Greg-R/magloop_pico_pcb_2/README.md

#  Printed Circuit Board for Magnetic Loop Antenna Controller Version 2

Design and fabrication files the Magnetic Loop Antenna Controller printed circuit board.

#  License

Please refer to the LICENSE file included in this repository.
