Greg-R/magloop_pico_pcb_2/bom/AmazonEbayPartsLoopController.ods

Sheet: Amazon
Amazon
Part | URL | Quantity for Project
Stepper Driver Module | https://www.amazon.com/gp/product/B01FFGAKK8
ILI9341 Display Module | https://www.amazon.com/gp/product/B073R7BH1B | 1
AD9850 DDS Module | https://www.amazon.com/gp/product/B01J7XPWNU | 1
Coaxial connector for relay | https://www.amazon.com/gp/product/B08Y7YWF3S | 1
Panel mount fuse holder and fuses | https://www.amazon.com/gp/product/B07VT4VRW7 | 1
Rotary encoders (not modules) with knobs | https://www.amazon.com/gp/product/B07DM2YMT4 | 3
Pushbuttons | https://www.amazon.com/gp/product/B0752RMB7Q | 3
Toggle switch for on/off | https://www.amazon.com/gp/product/B0799NSBHY | 1
Heatsink cooler fin for LM7805 | https://www.amazon.com/gp/product/B07MHT5KNP | 1
8 pin IDC connector with ribbon cable for display | https://www.amazon.com/gp/product/B07FKLHWT7 | 1
6 pin IDC connector with ribbon cable for push buttons and encoders | https://www.amazon.com/gp/product/B075PLZK9X | 2
JST connectors | https://www.amazon.com/gp/product/B01MCZE2HM | 3
JST crimping tool | https://www.amazon.com/gp/product/B01N4L8QMW | 1
Chanzon 1N5711, recommended diode | https://www.amazon.com/gp/product/B079KJBVZV | 4
Ethernet to screw terminal board, used at antenna | https://www.amazon.com/gp/product/B06XZ3BMTL | 1
Cat7 Ethernet Cable Outdoor rated | https://www.amazon.com/Outdoor-Ethernet-SNANSHI-1000Mbit-Waterproof/dp/B06ZZ1SKD6?th=1 | 1
Nylon hardware kit for assembling enclosure | https://www.amazon.com/HVAZI-Metric-Phillips-Screws-Assortment/dp/B07DVD95YY?th=1
Adhesive feet for controller enclosure | https://www.amazon.com/Bumper-Stopper-Protector-Adhesive-Headboard/dp/B0811DSRQB | 4
25 foot BNC cable | https://www.amazon.com/gp/product/B00K4D19IU?th=1 | 1
Plexiglas 10x10 | https://www.amazon.com/gp/product/B089P1KZ44?th=1 | 1
Large pulley 5mm bore | https://www.amazon.com/gp/product/B09NNBQP9T | 1
Small pulley 5mm bore | https://www.amazon.com/gp/product/B07DMWJJ6X?th=1 | 1
Belt, 6mm width, 260mm length | https://www.amazon.com/gp/product/B07B5Y4MGZ | 1
Limit switches | https://www.amazon.com/gp/product/B08CDF3Q6T | 2
Nylon bolts for antenna M8 30mm supports | https://www.amazon.com/gp/product/B012TAVQJW
Nylon bolts for tuner support brackets M8 40mm | https://www.amazon.com/gp/product/B0936RBF53
Nylon bolts for enclosure | https://www.amazon.com/gp/product/B07DVD95YY
Nylon bolts 6mm used on tuner assembly | https://www.amazon.com/gp/product/B07QWM86GX
Stepper Motor, 0.9 degree steps | https://www.amazon.com/gp/product/B0B8HB5N4S | 1

Sheet: eBay
eBay
Part | URL | Quantity for Project
Substitute for cancelled Digikey BNC | https://www.ebay.com/itm/232652734283
