Greg-R/magloop_pico_pcb_2/bom/MagLoop_Digikey.xlsx

Country of Origin may be different at time of shipment.
The HTSUS and ECCN information shown is for informational purposes only and is not a representation or warranty as to the accuracy or reliability of these classifications. All information is provided "as is" and is subject to change without notice. Any use made of the information provided is without recourse to Digi-Key and at the user's risk.
Index | Manufacturer Part Number | Manufacturer Name | Description | Availability | Stock Status | Attrition % | Requested Quantity 1 | Pack Quantity 1 | Pack Type 1 | Digi-Key Part Number 1 | Unit Price 1 | Extended Price 1 | Minimum Order Quantity 1 | Customer Reference | Requested Part Number | Lead Weeks | Datasheet | Reference Designator | US Import Tariff | Note | Part Status | RoHS Status | ECCN | HTSUS | Country of Origin | Environmental Information | Original Part numbers | Image
1 | PJ-036AH-SMT-TR | CUI Devices | CONN PWR JACK 2X5.5MM SOLDER | 63,562 | In Stock |  | 1 | 1 | Cut Tape (CT) | CP-036AHPJCT-ND | 1.43000 | $1.43 | 1 |  | CP-036AHPJCT-ND | 14 | https://www.cuidevices.com/product/resource/digikeypdf/pj-036ah-smt-tr.pdf |  | N/A |  | Active | ROHS3 Compliant | EAR99 | 8536.69.4040 | China | https://www.cuidevices.com/product/resource/material-compliance/pj-036ah-smt-tr | CP-036AHPJCT-ND | //media.digikey.com/photos/CUI%20Photos/MFG_PJ-036AH-SMT.jpg
2 | UVR1V100MDD | Nichicon | CAP ALUM 10UF 20% 35V RADIAL | 0 | Normally Stocking |  | 1 | 1 | Bulk | 493-1077-ND | 0.25000 | $0.25 | 1 |  | 493-1077-ND | 64 | https://download.datasheets.com/pdfs/2016/10/6/6/6/44/578/nch_/manual/93896153625063e-uvr.pdf |  | N/A |  | Active | ROHS3 Compliant | EAR99 | 8532.22.0020 | Malaysia |  | 493-1077-ND | //media.digikey.com/photos/Nichicon%20Photos/VR%20SERIES%20YELLOW%20HIGHLIGHT%20990-992.jpg
3 | ERJ-P08J752V | Panasonic Electronic Components | RES SMD 7.5K OHM 5% 2/3W 1206 | 2,311 | In Stock |  | 1 | 1 | Cut Tape (CT) | P7.5KALCT-ND | 0.17000 | $0.17 | 1 |  | P7.5KALCT-ND | 54 | https://industrial.panasonic.com/cdbs/www-data/pdf/RDO0000/AOA0000C331.pdf |  | N/A |  | Active | ROHS3 Compliant | EAR99 | 8533.21.0030 | Japan | https://industrial.panasonic.com/cdbs/www-cgi/auto-publishing.cgi?type=ROSU&region=WW&layer=4&cd=AOA0002 | P7.5KALCT-ND | //media.digikey.com/Renders/Panasonic%20Renders/ERJ-1206%20Pkg.jpg
4 | PPPC081LFBN-RC | Sullins Connector Solutions | CONN HDR 8POS 0.1 GOLD PCB | 92,192 | In Stock |  | 1 | 1 | Tray | S7041-ND | 0.67000 | $0.67 | 1 |  | S7041-ND | 11 | //media.digikey.com/pdf/Data%20Sheets/Sullins%20PDFs/Female_Headers.100_DS.pdf |  | N/A |  | Active | ROHS3 Compliant | EAR99 | 8536.69.4040 | Taiwan | https://www.sullinscorp.com/wp-content/uploads/2019/03/Sullins-RoHS-Compliant-Statement.pdf|https://www.sullinscorp.com/wp-content/uploads/2021/05/Sullins-REACH-211-SVHC-Compliant-Statement.pdf | S7041-ND | //media.digikey.com/photos/Sullins%20Photos/PPPC081LFBN-RC.jpg
5 | PPPC101LFBN-RC | Sullins Connector Solutions | CONN HDR 10POS 0.1 GOLD PCB | 130,868 | In Stock |  | 1 | 1 | Tray | S7043-ND | 0.68000 | $0.68 | 1 |  | S7043-ND | 11 | //media.digikey.com/pdf/Data%20Sheets/Sullins%20PDFs/Female_Headers.100_DS.pdf |  | N/A |  | Active | ROHS3 Compliant | EAR99 | 8536.69.4040 | Taiwan | https://www.sullinscorp.com/wp-content/uploads/2019/03/Sullins-RoHS-Compliant-Statement.pdf|https://www.sullinscorp.com/wp-content/uploads/2021/05/Sullins-REACH-211-SVHC-Compliant-Statement.pdf | S7043-ND | //media.digikey.com/photos/Sullins%20Photos/PPPC101LFBN-RC.jpg
6 | 2-406541-3 | TE Connectivity AMP Connectors | CONN MOD JACK 8P8C R/A SHIELDED | 6,301 | In Stock |  | 1 | 1 | Tray | A118429-ND | 2.57000 | $2.57 | 1 |  | A118429-ND | 27 | https://www.te.com/commerce/DocumentDelivery/DDEController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 |  | May apply on shipments to the U.S. |  | Active | RoHS Compliant | EAR99 | 8536.69.4040 | China |  | A118429-ND | //media.digikey.com/photos/TE%20Connectivity/2-406541-3.JPG
7 | ERJ-8GEYJ750V | Panasonic Electronic Components | RES SMD 75 OHM 5% 1/4W 1206 |  |  |  | 1 | 1 | Cut Tape (CT) | P75ECT-ND | 0.15000 | $0.15 | 1 |  | P75ECT-ND | 54 | https://industrial.panasonic.com/ww/products/pt/general-purpose-chip-resistors/models/ERJ8GEYJ750V |  | N/A |  |  | ROHS3 Compliant | EAR99 | 8533.21.0030 | Japan | https://industrial.panasonic.com/cdbs/www-cgi/auto-publishing.cgi?type=ROSU&region=WW&layer=4&cd=AOA0002 | P75ECT-ND | //media.digikey.com/Renders/Panasonic%20Renders/ERJ-1206%20Pkg.jpg
8 | RC1206FR-0710KL | YAGEO | RES 10K OHM 1% 1/4W 1206 | 2,137,700 | In Stock |  | 1 | 1 | Cut Tape (CT) | 311-10.0KFRCT-ND | 0.10000 | $0.10 | 1 |  | 311-10.0KFRCT-ND | 20 | https://www.yageo.com/upload/media/product/productsearch/datasheet/rchip/PYu-RC_Group_51_RoHS_L_11.pdf |  | May apply on shipments to the U.S. |  | Active | ROHS3 Compliant | EAR99 | 8533.21.0030 | Taiwan | https://www.yageo.com/en/Download/Index/certificates#rchip | 311-10.0KFRCT-ND | //media.digikey.com/Renders/Yageo%20Renders/Yageo-0603.jpg
9 | ERJ-8GEYJ513V | Panasonic Electronic Components | RES SMD 51K OHM 5% 1/4W 1206 |  |  |  | 1 | 1 | Cut Tape (CT) | P51KECT-ND | 0.15000 | $0.15 | 1 |  | P51KECT-ND | 54 | https://industrial.panasonic.com/ww/products/pt/general-purpose-chip-resistors/models/ERJ8GEYJ513V |  | N/A |  |  | ROHS3 Compliant | EAR99 | 8533.21.0030 | Japan | https://industrial.panasonic.com/cdbs/www-cgi/auto-publishing.cgi?type=ROSU&region=WW&layer=4&cd=AOA0002 | P51KECT-ND | //media.digikey.com/Renders/Panasonic%20Renders/ERJ-1206%20Pkg.jpg
10 | RMCF1206FT1K00 | Stackpole Electronics Inc | RES 1K OHM 1% 1/4W 1206 | 820,264 | In Stock |  | 1 | 1 | Cut Tape (CT) | RMCF1206FT1K00CT-ND | 0.10000 | $0.10 | 1 |  | RMCF1206FT1K00CT-ND | 17 | https://www.seielect.com/catalog/sei-rmcf_rmcp.pdf |  | May apply on shipments to the U.S. |  | Active | ROHS3 Compliant | EAR99 | 8533.21.0030 | Taiwan | https://www.seielect.com/catalog/reach.pdf|https://www.seielect.com/catalog/cert-of-compliance.pdf|https://www.seielect.com/catalog/SEI-RoHS_Compliance_Status.pdf | RMCF1206FT1K00CT-ND | //media.digikey.com/Renders/Stackpole%20Renders/1206.jpg
11 | PP3-002AH | CUI Devices | CONN PWR PLUG 2.1X5.5MM SOLDER | 3,286 | In Stock |  | 1 | 1 | Bag | CP3-002AH-ND | 1.64000 | $1.64 | 1 |  | CP3-002AH-ND | 15 | https://www.cuidevices.com/product/resource/digikeypdf/pp3-002ah.pdf |  | N/A |  | Active | ROHS3 Compliant | EAR99 | 8536.69.8000 | Taiwan | https://www.cuidevices.com/product/resource/material-compliance/pp3-002ah | CP3-002AH-ND | //media.digikey.com/Photos/CUI%20Photos/PP3-002AH.JPG
12 | 5-1634513-1 | TE Connectivity AMP Connectors | CONN BNC JACK R/A 50 OHM PCB |  | Obsolete |  | 1 |  |  |  |  |  |  |  | A97569-ND | 4 | https://www.te.com/commerce/DocumentDelivery/DDEController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 |  | N/A |  | Obsolete | RoHS Compliant | EAR99 | 8536.69.4010 | Taiwan | http://www.te.com/commerce/alt/SinglePartSearch.do?PN=5-1634513-1&dest=stmt | A97569-ND | //media.digikey.com/Photos/TE%20Connectivity/5-1634513-1.JPG
13 | S2G | SMC Diode Solutions | DIODE GEN PURP 400V 2A SMB | 21,388 | In Stock |  | 1 | 1 | Cut Tape (CT) | 1655-S2GCT-ND | 0.37000 | $0.37 | 1 |  | 1655-S2GCT-ND | 16 | https://www.smc-diodes.com/propdf/S2A-S2M%20N0562%20REV.A.pdf |  | May apply on shipments to the U.S. |  | Active | ROHS3 Compliant | EAR99 | 8541.10.0080 | China | http://www.smc-diodes.com/uploadfile/Declaration%20Letter%20for%20EU%20REACH-3.pdf|http://www.smc-diodes.com/uploadfile/ROHS%20Declaration%20Letter-3.pdf | 1655-S2GCT-ND | //media.digikey.com/Renders/SMC%20Diode%20Solutions/1655;SMB_DO214AA;;2.jpg
14 | CL31B104KBCNNNC | Samsung Electro-Mechanics | CAP CER 0.1UF 50V X7R 1206 | 1,739,651 | In Stock |  | 1 | 1 | Cut Tape (CT) | 1276-1017-1-ND | 0.12000 | $0.12 | 1 |  | 1276-1017-1-ND | 28 | //media.digikey.com/pdf/Data%20Sheets/Samsung%20PDFs/CL31B104KBCNNNC_Spec.pdf |  | N/A |  | Active | ROHS3 Compliant | EAR99 | 8532.24.0020 | Philippines | https://www.samsungsem.com/global/support/certificate/product-stewardship.do|https://www.samsungsem.com/files/fileDown.do?key=ed1dfdfa-645e-4252-b707-17f9b1502dd1 | 1276-1017-1-ND | //media.digikey.com/Renders/Samsung%20Electro-Mechanics%20America/Ceramic-Capacitor-CL-Series.jpg
15 | LM4040C30FTA | Diodes Incorporated | IC VREF SHUNT 0.5% SOT23 | 0 | Normally Stocking |  | 1 | 1 | Cut Tape (CT) | LM4040C30FTADICT-ND | 0.61000 | $0.61 | 1 |  | LM4040C30FTADICT-ND | 69 | https://www.diodes.com/assets/Datasheets/LM4040.pdf |  | May apply on shipments to the U.S. |  | Active | ROHS3 Compliant | EAR99 | 8542.39.0001 | China | https://www.diodes.com/assets/Quality-Reliability-Docs/Master_CofC.pdf | LM4040C30FTADICT-ND | //media.digikey.com/Renders/Diodes%20Renders/SOT-23-3%20PKG.jpg
16 | MBR0580-TP | Micro Commercial Co | DIODE SCHOTTKY 80V 500MA SOD123 | 108,267 | In Stock |  | 1 | 1 | Cut Tape (CT) | MBR0580-TPMSCT-ND | 0.35000 | $0.35 | 1 |  | MBR0580-TPMSCT-ND | 28 | https://www.mccsemi.com/pdf/Products/MBR0520-MBR0580(SOD123).pdf |  | May apply on shipments to the U.S. |  | Active | ROHS3 Compliant | EAR99 | 8541.10.0070 | China | https://www.mccsemi.com/pdf/pbfree/Certification%20of%20RoHS%20Compliance.pdf|https://www.mccsemi.com/pdf/pbfree/Certification%20of%20Compliance%20of%20CaliforniaProposition65.pdf|https://www.mccsemi.com/pdf/pbfree/Certification%20of%20REACH%20Compliance.pdf | MBR0580-TPMSCT-ND | //media.digikey.com/Renders/Micro%20Commercial%20Renders/SOD-123.jpg
17 | ERJ-8GEYJ472V | Panasonic Electronic Components | RES SMD 4.7K OHM 5% 1/4W 1206 | 144,268 | In Stock |  | 1 | 1 | Cut Tape (CT) | P4.7KECT-ND | 0.15000 | $0.15 | 1 |  | P4.7KECT-ND | 54 | https://industrial.panasonic.com/ww/products/pt/general-purpose-chip-resistors/models/ERJ8GEYJ472V |  | N/A |  |  | ROHS3 Compliant | EAR99 | 8533.21.0030 | Japan | https://industrial.panasonic.com/cdbs/www-cgi/auto-publishing.cgi?type=ROSU&region=WW&layer=4&cd=AOA0002 | P4.7KECT-ND | //media.digikey.com/Renders/Panasonic%20Renders/ERJ-1206%20Pkg.jpg
18 | CC1206KRX7R9BB471 | YAGEO | CAP CER 470PF 50V X7R 1206 | 39,533 | In Stock |  | 1 | 1 | Cut Tape (CT) | 311-1167-1-ND | 0.23000 | $0.23 | 1 |  | 311-1167-1-ND | 20 | https://www.yageo.com/upload/media/product/productsearch/datasheet/mlcc/UPY-GPHC_X7R_6.3V-to-50V_20.pdf |  | N/A |  | Active | ROHS3 Compliant | EAR99 | 8532.24.0020 | Taiwan |  | 311-1167-1-ND | //media.digikey.com/Renders/Yageo%20Renders/1206%280%5E7mm%20thickness%29.jpg
19 | B2B-XH-A-GU | JST Sales America Inc. | CONN HEADER VERT 2POS 2.5MM | 54,025 | In Stock |  | 1 | 1 | Bulk | 455-2946-ND | 0.24000 | $0.24 | 1 |  | 455-2946-ND | 34 | https://www.jst-mfg.com/product/pdf/eng/eXH.pdf |  | N/A |  | Active | RoHS Compliant | EAR99 | 8536.69.4040 | China |  | 455-2946-ND | //media.digikey.com/Photos/JST%20Photos/B2B-XH-A-GU.JPG
20 | DMP31D0U-7 | Diodes Incorporated | MOSFET P-CH 30V 530MA SOT23 | 649 | In Stock |  | 1 | 1 | Cut Tape (CT) | DMP31D0U-7DICT-ND | 0.47000 | $0.47 | 1 |  | DMP31D0U-7DICT-ND | 90 | https://www.diodes.com/assets/Datasheets/DMP31D0U.pdf |  | May apply on shipments to the U.S. |  | Active | ROHS3 Compliant | EAR99 | 8541.21.0095 | China | https://www.diodes.com/assets/Quality-Reliability-Docs/Master_CofC.pdf | DMP31D0U-7DICT-ND | //media.digikey.com/Renders/Diodes%20Renders/SOT-23-3%20PKG.jpg
21 | MMBT3904,215 | Nexperia USA Inc. | TRANS NPN 40V 0.2A TO236AB | 507,080 | In Stock |  | 1 | 1 | Cut Tape (CT) | 1727-4044-1-ND | 0.12000 | $0.12 | 1 |  | 1727-4044-1-ND | 27 | https://assets.nexperia.com/documents/data-sheet/MMBT3904.pdf |  | May apply on shipments to the U.S. |  | Active | ROHS3 Compliant | EAR99 | 8541.21.0075 | China |  | 1727-4044-1-ND | //media.digikey.com/Photos/Nexperia/MFG_SOT23.jpg
22 | LM358P | Texas Instruments | IC OPAMP GP 2 CIRCUIT 8DIP | 13,317 | In Stock |  | 2 | 2 | Tube | 296-1395-5-ND | 0.49000 | $0.98 | 1 |  | 296-1395-5-ND | 35 | https://www.ti.com/general/docs/suppproductinfo.tsp?distId=10 |  | May apply on shipments to the U.S. |  | Active | ROHS3 Compliant | EAR99 | 8542.33.0001 | China |  | 296-1395-5-ND | //media.digikey.com/Photos/Rochester/MFG_TC254P.jpg.jpg
23 | ERJ-8GEYJ272V | Panasonic Electronic Components | RES SMD 2.7K OHM 5% 1/4W 1206 | 149,367 | In Stock |  | 1 | 1 | Cut Tape (CT) | P2.7KECT-ND | 0.15000 | $0.15 | 1 |  | P2.7KECT-ND | 54 | https://industrial.panasonic.com/ww/products/pt/general-purpose-chip-resistors/models/ERJ8GEYJ272V |  | N/A |  |  | ROHS3 Compliant | EAR99 | 8533.21.0030 | Japan | https://industrial.panasonic.com/cdbs/www-cgi/auto-publishing.cgi?type=ROSU&region=WW&layer=4&cd=AOA0002 | P2.7KECT-ND | //media.digikey.com/Renders/Panasonic%20Renders/ERJ-1206%20Pkg.jpg
24 | ERJ-8ENF5100V | Panasonic Electronic Components | RES SMD 510 OHM 1% 1/4W 1206 | 76,423 | In Stock |  | 1 | 1 | Cut Tape (CT) | P510FCT-ND | 0.20000 | $0.20 | 1 |  | P510FCT-ND | 54 | https://industrial.panasonic.com/cdbs/www-data/pdf/RDA0000/AOA0000C304.pdf |  | N/A |  |  | ROHS3 Compliant | EAR99 | 8533.21.0030 | Japan | https://industrial.panasonic.com/cdbs/www-cgi/auto-publishing.cgi?type=ROSU&region=WW&layer=4&cd=AOA0002 | P510FCT-ND | //media.digikey.com/Renders/Panasonic%20Renders/ERJ-1206%20Pkg.jpg
25 | ERJ-P08J201V | Panasonic Electronic Components | RES SMD 200 OHM 5% 2/3W 1206 | 15,554 | In Stock |  | 1 | 1 | Cut Tape (CT) | P200ALCT-ND | 0.17000 | $0.17 | 1 |  | P200ALCT-ND | 54 | https://industrial.panasonic.com/cdbs/www-data/pdf/RDO0000/AOA0000C331.pdf |  | N/A |  | Active | ROHS3 Compliant | EAR99 | 8533.21.0030 | Japan | https://industrial.panasonic.com/cdbs/www-cgi/auto-publishing.cgi?type=ROSU&region=WW&layer=4&cd=AOA0002 | P200ALCT-ND | //media.digikey.com/Renders/Panasonic%20Renders/ERJ-1206%20Pkg.jpg
26 | ERJ-8ENF43R0V | Panasonic Electronic Components | RES SMD 43 OHM 1% 1/4W 1206 | 56,385 | In Stock |  | 1 | 1 | Cut Tape (CT) | P43.0FCT-ND | 0.20000 | $0.20 | 1 |  | P43.0FCT-ND | 54 | https://industrial.panasonic.com/cdbs/www-data/pdf/RDA0000/AOA0000C304.pdf |  | N/A |  |  | ROHS3 Compliant | EAR99 | 8533.21.0030 | Japan | https://industrial.panasonic.com/cdbs/www-cgi/auto-publishing.cgi?type=ROSU&region=WW&layer=4&cd=AOA0002 | P43.0FCT-ND | //media.digikey.com/Renders/Panasonic%20Renders/ERJ-1206%20Pkg.jpg
27 | ERJ-8GEYJ391V | Panasonic Electronic Components | RES SMD 390 OHM 5% 1/4W 1206 | 211,714 | In Stock |  | 1 | 1 | Cut Tape (CT) | P390ECT-ND | 0.15000 | $0.15 | 1 |  | P390ECT-ND | 54 | https://industrial.panasonic.com/ww/products/pt/general-purpose-chip-resistors/models/ERJ8GEYJ391V |  | N/A |  |  | ROHS3 Compliant | EAR99 | 8533.21.0030 | Japan | https://industrial.panasonic.com/cdbs/www-cgi/auto-publishing.cgi?type=ROSU&region=WW&layer=4&cd=AOA0002 | P390ECT-ND | //media.digikey.com/Renders/Panasonic%20Renders/ERJ-1206%20Pkg.jpg
28 | ERJ-8ENF24R9V | Panasonic Electronic Components | RES SMD 24.9 OHM 1% 1/4W 1206 | 5,357 | In Stock |  | 1 | 1 | Cut Tape (CT) | P24.9FCT-ND | 0.20000 | $0.20 | 1 |  | P24.9FCT-ND | 54 | https://industrial.panasonic.com/cdbs/www-data/pdf/RDA0000/AOA0000C304.pdf |  | N/A |  |  | ROHS3 Compliant | EAR99 | 8533.21.0030 | Japan | https://industrial.panasonic.com/cdbs/www-cgi/auto-publishing.cgi?type=ROSU&region=WW&layer=4&cd=AOA0002 | P24.9FCT-ND | //media.digikey.com/Renders/Panasonic%20Renders/ERJ-1206%20Pkg.jpg
29 | ERJ-8GEYJ222V | Panasonic Electronic Components | RES SMD 2.2K OHM 5% 1/4W 1206 | 1,505,502 | In Stock |  | 1 | 1 | Cut Tape (CT) | P2.2KECT-ND | 0.15000 | $0.15 | 1 |  | P2.2KECT-ND | 54 | https://industrial.panasonic.com/ww/products/pt/general-purpose-chip-resistors/models/ERJ8GEYJ222V |  | N/A |  |  | ROHS3 Compliant | EAR99 | 8533.21.0030 | Japan | https://industrial.panasonic.com/cdbs/www-cgi/auto-publishing.cgi?type=ROSU&region=WW&layer=4&cd=AOA0002 | P2.2KECT-ND | //media.digikey.com/Renders/Panasonic%20Renders/ERJ-1206%20Pkg.jpg
30 | ERJ-8GEYJ510V | Panasonic Electronic Components | RES SMD 51 OHM 5% 1/4W 1206 | 43,802 | In Stock |  | 1 | 1 | Cut Tape (CT) | P51ECT-ND | 0.15000 | $0.15 | 1 |  | P51ECT-ND | 54 | https://industrial.panasonic.com/ww/products/pt/general-purpose-chip-resistors/models/ERJ8GEYJ510V |  | N/A |  |  | ROHS3 Compliant | EAR99 | 8533.21.0030 | Japan | https://industrial.panasonic.com/cdbs/www-cgi/auto-publishing.cgi?type=ROSU&region=WW&layer=4&cd=AOA0002 | P51ECT-ND | //media.digikey.com/Renders/Panasonic%20Renders/ERJ-1206%20Pkg.jpg
31 | ERJ-8GEYJ105V | Panasonic Electronic Components | RES SMD 1M OHM 5% 1/4W 1206 | 116,279 | In Stock |  | 1 | 1 | Cut Tape (CT) | P1.0MECT-ND | 0.15000 | $0.15 | 1 |  | P1.0MECT-ND | 54 | https://industrial.panasonic.com/ww/products/pt/general-purpose-chip-resistors/models/ERJ8GEYJ105V |  | N/A |  |  | ROHS3 Compliant | EAR99 | 8533.21.0030 | Japan | https://industrial.panasonic.com/cdbs/www-cgi/auto-publishing.cgi?type=ROSU&region=WW&layer=4&cd=AOA0002 | P1.0MECT-ND | //media.digikey.com/Renders/Panasonic%20Renders/ERJ-1206%20Pkg.jpg
32 | ERJ-8GEYJ243V | Panasonic Electronic Components | RES SMD 24K OHM 5% 1/4W 1206 | 20,248 | In Stock |  | 1 | 1 | Cut Tape (CT) | P24KECT-ND | 0.15000 | $0.15 | 1 |  | P24KECT-ND | 54 | https://industrial.panasonic.com/ww/products/pt/general-purpose-chip-resistors/models/ERJ8GEYJ243V |  | N/A |  |  | ROHS3 Compliant | EAR99 | 8533.21.0030 | Japan | https://industrial.panasonic.com/cdbs/www-cgi/auto-publishing.cgi?type=ROSU&region=WW&layer=4&cd=AOA0002 | P24KECT-ND | //media.digikey.com/Renders/Panasonic%20Renders/ERJ-1206%20Pkg.jpg
33 | PPPC201LFBN-RC | Sullins Connector Solutions | CONN HDR 20POS 0.1 GOLD PCB | 14,630 | In Stock |  | 1 | 1 | Tray | S7053-ND | 1.28000 | $1.28 | 1 |  | S7053-ND | 11 | //media.digikey.com/pdf/Data%20Sheets/Sullins%20PDFs/Female_Headers.100_DS.pdf |  | N/A |  | Active | ROHS3 Compliant | EAR99 | 8536.69.4040 | Taiwan | https://www.sullinscorp.com/wp-content/uploads/2019/03/Sullins-RoHS-Compliant-Statement.pdf|https://www.sullinscorp.com/wp-content/uploads/2021/05/Sullins-REACH-211-SVHC-Compliant-Statement.pdf | S7053-ND | //media.digikey.com/photos/Sullins%20Photos/PPPC201LFBN-RC.jpg
34 | PH1-20-UA | Adam Tech | CONN HEADER VERT 20POS 2.54MM | 11,761 | In Stock |  | 1 | 1 | Bag | 2057-PH1-20-UA-ND | 0.32000 | $0.32 | 1 |  | 2057-PH1-20-UA-ND | 10 | https://app.adam-tech.com/products/download/data_sheet/201605/ph1-xx-ua-data-sheet.pdf |  | N/A |  | Active | ROHS3 Compliant | EAR99 | 8536.69.4040 | Taiwan |  | 2057-PH1-20-UA-ND | //media.digikey.com/Renders/Adam-Tech%20Renders/PH1-xx-UA.jpg
