Greg-R/magloop_pico_pcb_2/magloop_pico.pdf

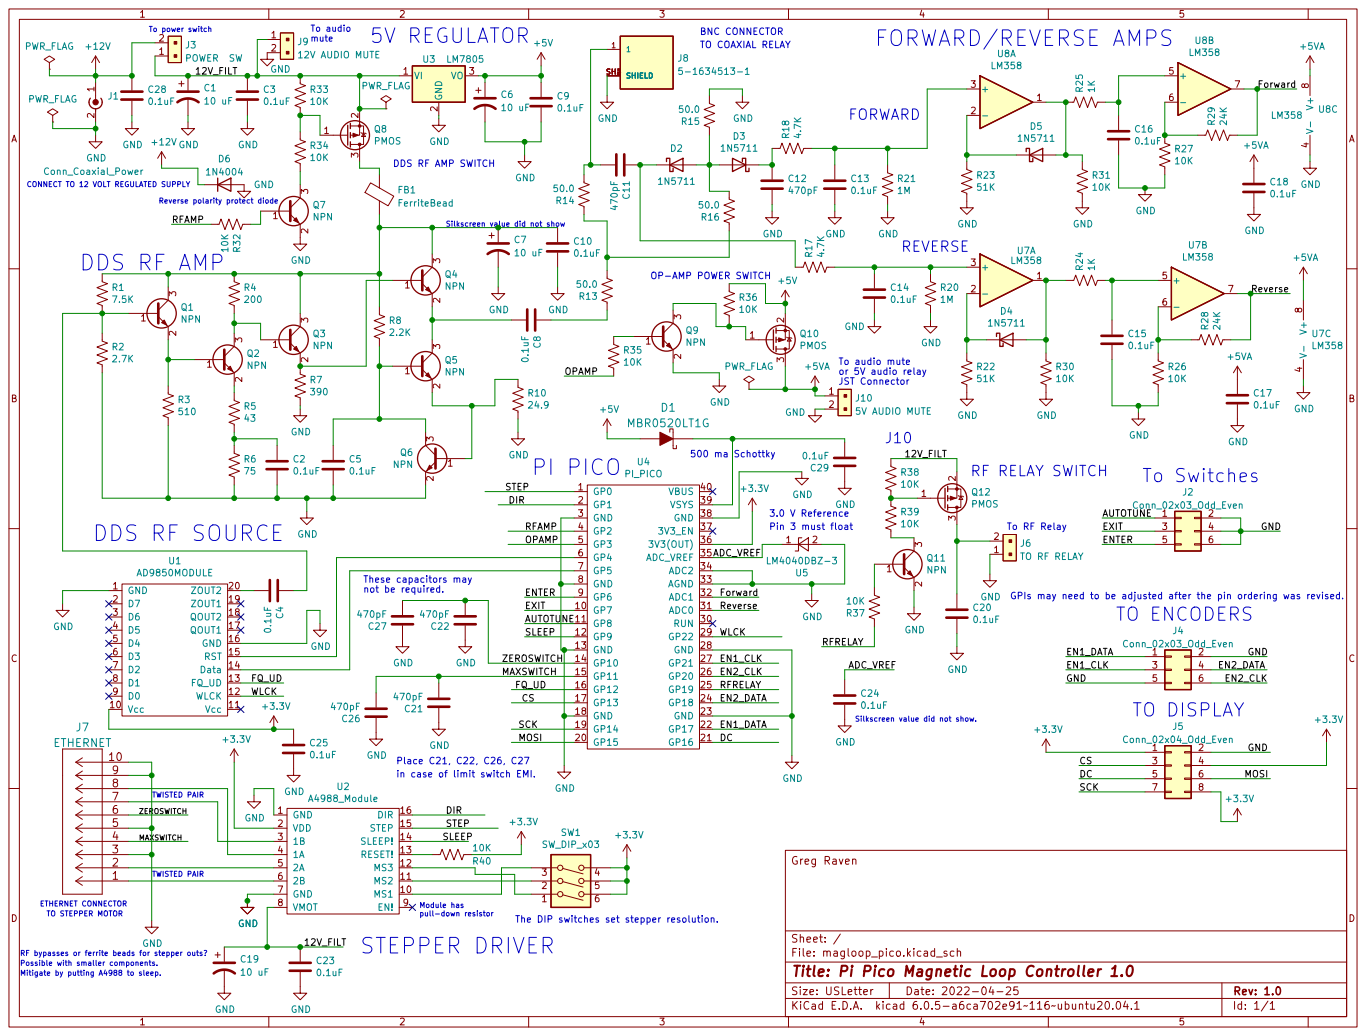
[picture p1: page 1]

To power switch CONNECT TO 12 VOLT REGULATED SUPPLY
PWR_FLAG

GPIs may need to be adjusted after the pin ordering was revised. DDS RF AMP SWITCH

Silkscreen value did not show

2 3 Q12 PMOS GND GND GND

3.0 V Reference Pin 3 must float DDS RF AMP

OP-AMP POWER SWITCH

not be required. TO STEPPER MOTOR

Silkscreen value did not show. TWISTED PAIR

7 | TWISTED PAIR

File: magloop_pico.kicad_sch Sheet: / Greg Raven

The DIP switches set stepper resolution.

RF bypasses or ferrite beads for stepper outs? Possible with smaller components.

Id: 1/1 Title: Pi Pico Magnetic Loop Controller 1.0
