Greg-R/magloop_pico_pcb_2/magloop_pico.kicad_pcb

## KiCad design magloop_pico.kicad_pcb (2024-08-24)

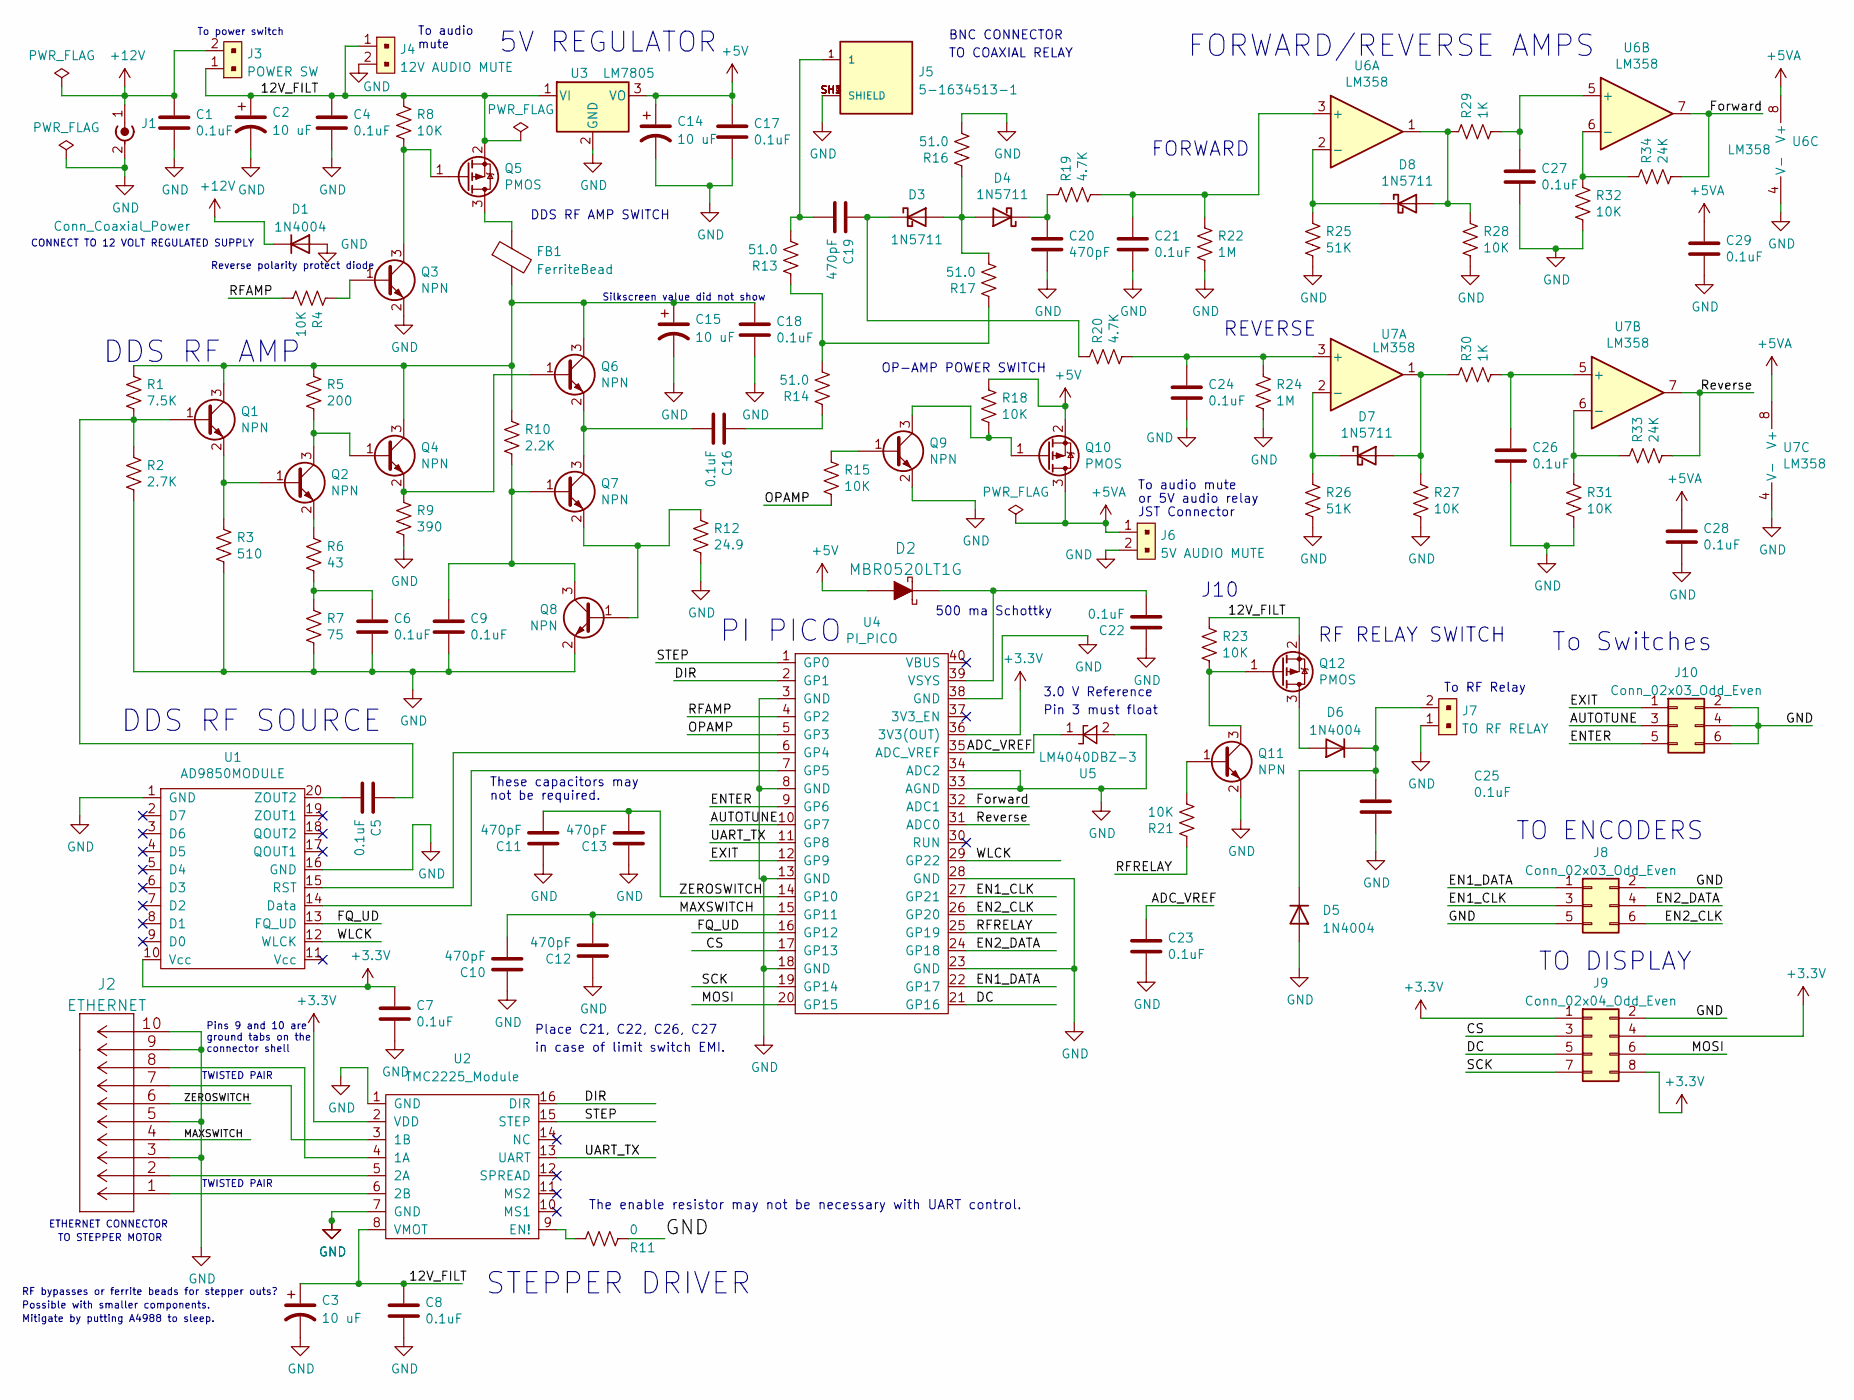
[picture p2: schematic magloop_pico.kicad_sch, Pi Pico Magnetic Loop Controller 2.0]

Parts:
C1, C4, C5, C6, C7, C8, C9, C16, C17, C18, C21, C22, C23, C24, C25, C26, C27, C28, C29: 0.1uF; C_1206_3216Metric_Pad1.33x1.80mm_HandSolder
C2, C3, C14, C15: 10 uF; CP_Radial_D5.0mm_P2.00mm
C10, C11, C12, C13, C19, C20: 470pF; C_1206_3216Metric_Pad1.33x1.80mm_HandSolder
D1, D5, D6: 1N4004; D_SMB
D2: MBR0520LT1G; SOD-123; MPN MBR0520LT1G; Digi-Key_PN MBR0520LT1GOSCT-ND
D3, D4, D7, D8: 1N5711; D_DO-35_SOD27_P7.62mm_Horizontal
FB1: FerriteBead; L_1206_3216Metric
J1: Conn_Coaxial_Power; BarrelJack_CUI_PJ-036AH-SMT_Horizontal
J2: ETHERNET; 2-406541-3
J3: POWER SW; PinHeader_1x2_P2.5mm_Drill1.1mm; MPN B2B-XH-A(LF)(SN); Digi-Key_PN 455-2247-ND
J4: 12V AUDIO MUTE; PinHeader_1x2_P2.5mm_Drill1.1mm; MPN B2B-XH-A(LF)(SN); Digi-Key_PN 455-2247-ND
J5: 5-1634513-1; TE_5-1634513-1
J6: 5V AUDIO MUTE; PinHeader_1x2_P2.5mm_Drill1.1mm; MPN B2B-XH-A(LF)(SN); Digi-Key_PN 455-2247-ND
J7: TO RF RELAY; PinHeader_1x2_P2.5mm_Drill1.1mm; MPN B2B-XH-A(LF)(SN); Digi-Key_PN 455-2247-ND
J8, J10: Conn_02x03_Odd_Even; IDC-Header_2x03_P2.54mm_Vertical
J9: Conn_02x04_Odd_Even; IDC-Header_2x04_P2.54mm_Vertical
Q1, Q2, Q3, Q4, Q6, Q7, Q8, Q9, Q11: NPN; SOT-23
Q5, Q10, Q12: PMOS; SOT-23
R1: 7.5K; R_1206_3216Metric_Pad1.30x1.75mm_HandSolder
R2: 2.7K; R_1206_3216Metric_Pad1.30x1.75mm_HandSolder
R3: 510; R_1206_3216Metric_Pad1.30x1.75mm_HandSolder
R4, R8, R15, R18, R21, R23, R27, R28, R31, R32: 10K; R_1206_3216Metric_Pad1.30x1.75mm_HandSolder
R5: 200; R_1206_3216Metric_Pad1.30x1.75mm_HandSolder
R6: 43; R_1206_3216Metric_Pad1.30x1.75mm_HandSolder
R7: 75; R_1206_3216Metric_Pad1.30x1.75mm_HandSolder
R9: 390; R_1206_3216Metric_Pad1.30x1.75mm_HandSolder
R10: 2.2K; R_1206_3216Metric_Pad1.30x1.75mm_HandSolder
R11: 0; R_1206_3216Metric_Pad1.30x1.75mm_HandSolder
R12: 24.9; R_1206_3216Metric_Pad1.30x1.75mm_HandSolder
R13, R14, R16, R17: 51.0; R_1206_3216Metric_Pad1.30x1.75mm_HandSolder
R19, R20: 4.7K; R_1206_3216Metric_Pad1.30x1.75mm_HandSolder
R22, R24: 1M; R_1206_3216Metric_Pad1.30x1.75mm_HandSolder
R25, R26: 51K; R_1206_3216Metric_Pad1.30x1.75mm_HandSolder
R29, R30: 1K; R_1206_3216Metric_Pad1.30x1.75mm_HandSolder
R33, R34: 24K; R_1206_3216Metric_Pad1.30x1.75mm_HandSolder
U1: AD9850MODULE; AD9850_MODULE
U2: TMC2225_Module; TMC2209_MODULE
U3: LM7805; TO-220-3_Vertical
U4: PI_PICO
U5: LM4040DBZ-3; SOT-23
U6, U7: LM358; SOIC-8_3.9x4.9mm_P1.27mm

Connections:
+3.3V: C7.1, J9.1, J9.4, J9.8, U1.10 (Vcc), U2.2 (VDD), U4.36 (3V3(OUT))
+5V: C14.1, C17.1, D2.A, Q10.2 (S), R18.1, U3.3 (VO)
+5VA: C28.1, C29.1, J6.1, Q10.3 (D), U6.8 (V+), U7.8 (V+)
+12V: C1.1, D1.1 (K), J1.1 (In), J3.2
/12V_FILT: C2.1, C3.1, C4.1, C8.1, J3.1, J4.1, Q5.2 (S), Q12.2 (S), R8.1, R23.1, U2.8 (VMOT), U3.1 (VI)
/ADC_VREF: C23.1, U4.35 (ADC_VREF), U5.1 (K)
/AUTOTUNE: J10.3, U4.10 (GP7)
/CS: J9.3, U4.17 (GP13)
/DC: J9.5, U4.21 (GP16)
/DIR: U2.16 (DIR), U4.2 (GP1)
/EN1_CLK: J8.3, U4.27 (GP21)
/EN1_DATA: J8.1, U4.22 (GP17)
/EN2_CLK: J8.6, U4.26 (GP20)
/EN2_DATA: J8.4, U4.24 (GP18)
/ENTER: J10.5, U4.9 (GP6)
/EXIT: J10.1, U4.12 (GP9)
/FQ_UD: U1.13 (FQ_UD), U4.16 (GP12)
/Forward: R34.2, U4.32 (ADC1), U6.7
/MAXSWITCH: C10.2, C12.2, J2.4, U4.15 (GP11)
/MOSI: J9.6, U4.20 (GP15)
/OPAMP: R15.2, U4.5 (GP3)
/RFAMP: R4.2, U4.4 (GP2)
/RFRELAY: R21.1, U4.25 (GP19)
/Reverse: R33.2, U4.31 (ADC0), U7.7
/SCK: J9.7, U4.19 (GP14)
/STEP: U2.15 (STEP), U4.1 (GP0)
/UART_TX: U2.13 (UART), U4.11 (GP8)
/WLCK: U1.12 (WLCK), U4.29 (GP22)
/ZEROSWITCH: C11.2, C13.2, J2.6, U4.14 (GP10)
GND: C1.2, C2.2, C3.2, C4.2, C6.2, C7.2, C8.2, C9.2, C10.1, C11.1, C12.1, C13.1, C14.2, C15.2, C17.2, C18.2, C20.2, C21.2, C22.1, C23.2, C24.2, C25.2, C26.2, C27.2, C28.2, C29.2, D1.2 (A), D5.2 (A), J1.2 (Ext), J2.3, J2.5, J2.9, J2.10, J4.2, J5.SH1 (SHIELD), J5.SH2 (SHIELD), J5.SH3 (SHIELD), J5.SH4 (SHIELD), J6.2, J7.1, J8.2, J8.5, J9.2, J10.2, J10.4, J10.6, Q3.2 (E), Q8.2 (E), Q9.2 (E), Q11.2 (E), R2.2, R3.2, R7.2, R9.2, R11.1, R12.2, R16.2, R22.2, R24.2, R25.2, R26.2, R27.2, R28.2, R31.2, R32.2, U1.1 (GND), U1.16 (GND), U2.1 (GND), U2.7 (GND), U3.2 (GND), U4.3 (GND), U4.8 (GND), U4.13 (GND), U4.18 (GND), U4.23 (GND), U4.28 (GND), U4.33 (AGND), U4.34 (ADC2), U4.38 (GND), U5.2 (A), U6.4 (V-), U7.4 (V-)
unnamed: C6.1, R6.2, R7.1
unnamed: C16.1, R14.1
unnamed: C19.2, J5.1, R13.2
unnamed: D3.2 (A), D4.2 (A), R16.1, R17.2
unnamed: C19.1, D3.1 (K), R20.1
unnamed: C20.1, D4.1 (K), R19.1
unnamed: C25.1, D5.1 (K), D6.1 (K), J7.2
unnamed: D6.2 (A), Q12.3 (D)
unnamed: D7.2 (A), R27.1, R30.1, U7.1
unnamed: D7.1 (K), R26.1, U7.2 (-)
unnamed: D8.2 (A), R28.1, R29.1, U6.1
unnamed: D8.1 (K), R25.1, U6.2 (-)
unnamed: C5.1, Q1.1 (B), R1.2, R2.1
unnamed: C15.1, C18.1, FB1.2, Q1.3 (C), Q4.3 (C), Q6.3 (C), R1.1, R5.1, R10.1
unnamed: Q1.2 (E), Q2.1 (B), R3.1
unnamed: Q2.3 (C), Q4.1 (B), R5.2
unnamed: Q2.2 (E), R6.1
unnamed: Q3.1 (B), R4.1
unnamed: Q3.3 (C), Q5.1 (G), R8.2
unnamed: Q4.2 (E), Q6.1 (B), R9.1
unnamed: FB1.1, Q5.3 (D)
unnamed: C16.2, Q6.2 (E), Q7.3 (C)
unnamed: C9.1, Q7.1 (B), Q8.3 (C), R10.2
unnamed: Q7.2 (E), Q8.1 (B), R12.1
unnamed: Q9.1 (B), R15.1
unnamed: Q9.3 (C), Q10.1 (G), R18.2
unnamed: Q11.1 (B), R21.2
unnamed: Q11.3 (C), Q12.1 (G), R23.2
unnamed: R13.1, R14.2, R17.1
unnamed: U1.14 (Data), U4.7 (GP5)
unnamed: U1.15 (RST), U4.6 (GP4)
unnamed: C5.2, U1.20 (ZOUT2)
unnamed: J2.8, U2.4 (1A)
unnamed: J2.7, U2.3 (1B)
unnamed: J2.2, U2.5 (2A)
unnamed: J2.1, U2.6 (2B)
unnamed: R11.2, U2.9 (EN!)
unnamed: C22.2, D2.K, U4.39 (VSYS)
unnamed: C21.1, R19.2, R22.1, U6.3 (+)
unnamed: C27.1, R29.2, U6.5 (+)
unnamed: R32.1, R34.1, U6.6 (-)
unnamed: C24.1, R20.2, R24.1, U7.3 (+)
unnamed: C26.1, R30.2, U7.5 (+)
unnamed: R31.1, R33.1, U7.6 (-)

Notes on the sheet:
To RF Relay
CONNECT TO 12 VOLT REGULATED SUPPLY
PI PICO
STEPPER DRIVER
To audio mute
JST Connector
BNC CONNECTOR
To Switches
Reverse polarity protect diode
DDS RF AMP SWITCH
or 5V audio relay
TWISTED PAIR
ETHERNET CONNECTOR
Silkscreen value did not show
TO STEPPER MOTOR
J10
RF bypasses or ferrite beads for stepper outs?
OP-AMP POWER SWITCH
5V REGULATOR
REVERSE
To audio
To power switch
DDS RF SOURCE
TO COAXIAL RELAY
Place C21, C22, C26, C27
TO ENCODERS
500 ma Schottky
FORWARD
DDS RF AMP
Pins 9 and 10 are ground tabs on the connector shell
These capacitors may
Possible with smaller components.
TO DISPLAY
Mitigate by putting A4988 to sleep.
FORWARD/REVERSE AMPS
Pin 3 must float
3.0 V Reference
mute
not be required.
RF RELAY SWITCH
in case of limit switch EMI.
The enable resistor may not be necessary with UART control.

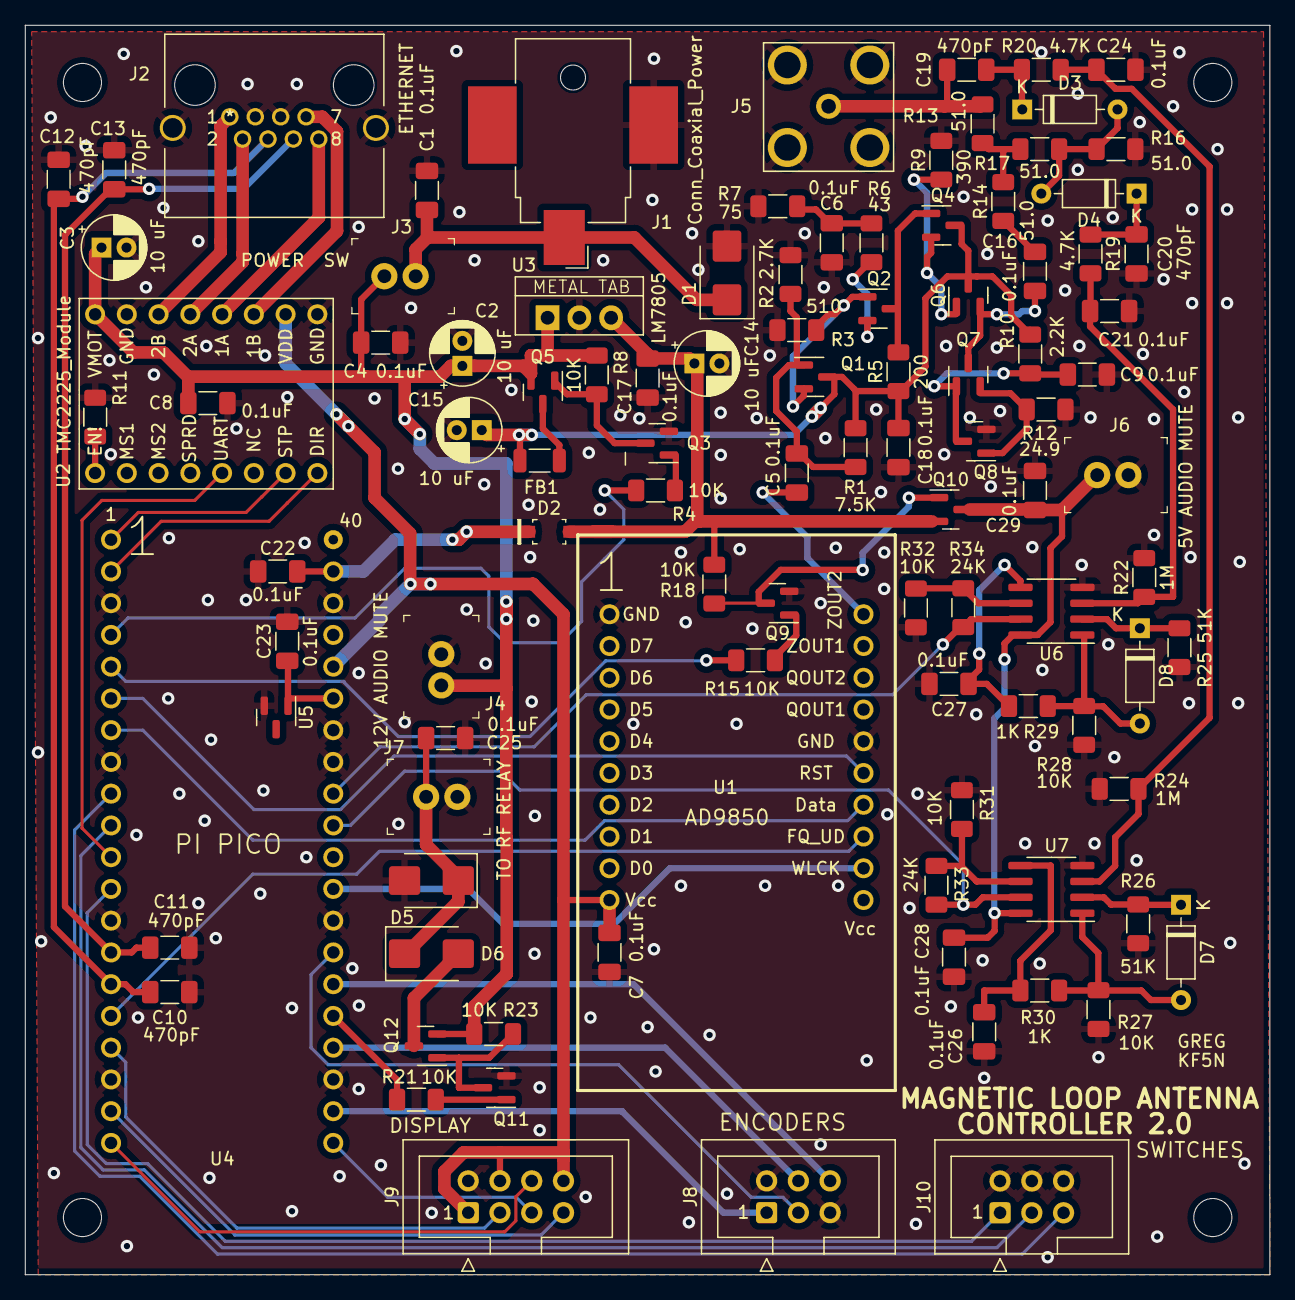
[picture p3: board magloop_pico.kicad_pcb from above]

Board: 2 copper layers, 99.6 x 99.9 mm, 101 parts (0 on the bottom side), 74 nets.
