Greg-R/magloop_pico_pcb_2/(threads)

Thread 1 (2024-03-29):

Wow this! And a few questions

kelogs, 2024-03-29:
Even put an 87 page document together, wow!

if you do not mind:

- there are not so many capacitor bank tuners, most are motor & varicap based. Why so?
- if I understand correctly this is a real tuner and not an impedance matcher, is that so ?
- seen those 3 bom files, but... do you recall what the bill was for accomplishing this feat ?

Thank you!
