Greg-R/magloop_pico_pcb_2/(commit log)

2023-01-27 Root commit.
    [AmazonEbayPartsLoopController.ods, MagLoop_Digikey.xlsx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]
2023-04-05 Got all nets wired. Not clean yet.
    [magloop_pico.kicad_pcb, magloop_pico.kicad_sch]
2023-04-06 Layout clean
    [magloop_pico.kicad_pcb]
2023-04-08 This commit prior to experiment re-ordering schematic designators.
    [magloop_pico-B_Cu.gbl, magloop_pico-B_Mask.gbs, magloop_pico-B_Silkscreen.gbo, magloop_pico-Edge_Cuts.gm1, magloop_pico-F_Cu.gtl, magloop_pico-F_Mask.gts, magloop_pico-F_Silkscreen.gto, magloop_pico-NPTH.drl]
2023-04-08 Seems to be clean. Wait another 24 hours before release.
    [magloop_pico-B_Cu.gbl, magloop_pico-B_Mask.gbs, magloop_pico-B_Silkscreen.gbo, magloop_pico-Edge_Cuts.gm1, magloop_pico-F_Cu.gtl, magloop_pico-F_Mask.gts, magloop_pico-F_Silkscreen.gto, magloop_pico-NPTH.drl]
2023-04-10 Released to PCBWay.
    [magloop_pico-B_Cu.gbl, magloop_pico-B_Mask.gbs, magloop_pico-B_Silkscreen.gbo, magloop_pico-Edge_Cuts.gm1, magloop_pico-F_Cu.gtl, magloop_pico-F_Mask.gts, magloop_pico-F_Silkscreen.gto, magloop_pico-NPTH.drl]
2023-05-27 Updated BOM to show 0.9 degree stepper motor, delete DIP switch.
    [AmazonEbayPartsLoopController.ods]
2024-08-24 Fixed BOM problem with R5.
    [magloop_pico.kicad_pcb, magloop_pico.kicad_sch, magloop_pico_Kicad.csv]
